iandchasse/de-link-pcb/simulations/led_driver/LED_circuit.asc

3v3_s: voltage; 3.3
C1: cap; 4.7µ
C2: cap; 4.7µ
C3: cap; 22µ
D1: schottky; MBR0540
D2: schottky; MBR0540
D8: LED; led_s; N=7
L1: ind; 10µ; Ipk=1.1 Rser=0.42 Rpar=7751.58 Cpar=0
M1: pmos; irlml6402
M2: pmos; irlml6402
Q1: npn
R1: res; 10k
R2: res; 10k
R3: res; 82
R4: res; 10k
R5: res; 10k
U1: LT1615
V1: voltage; 3.3
V2: voltage; 0
V3: voltage; PULSE(0 3.3v 0 1u 1u 5m 10m)
V4: voltage; PULSE(0 5v 0 1u 1u 5m 10m)
Named nets: 0, 3v3, LED_SW, LED_SENSE, LED_RET, LDO_IN
.SUBCKT irlml6402 1 2 3
**************************************
*      Model Generated by MODPEX     *
*Copyright(c) Symmetry Design Systems*
*         All Rights Reserved        *
*    UNPUBLISHED LICENSED SOFTWARE   *
*   Contains Proprietary Information *
*      Which is The Property of      *
*     SYMMETRY OR ITS LICENSORS      *
*Commercial Use or Resale Restricted *
*   by Symmetry License Agreement    *
**************************************
* Model generated on Sep 25, 06
* MODEL FORMAT: SPICE3
* Symmetry POWER MOS Model (Version 1.0)
* External Node Designations
* Node 1 -> Drain
* Node 2 -> Gate
* Node 3 -> Source
M1 9 7 8 8 MM L=100u W=100u
.MODEL MM PMOS LEVEL=1 IS=1e-32
+VTO=-1 LAMBDA=0.0111358 KP=12.788
+CGSO=5.36099e-06 CGDO=5.54234e-08
RS 8 3 0.0246704
D1 1 3 MD
.MODEL MD D IS=2.03395e-08 RS=0.0432758 N=1.5 BV=20
+IBV=0.00025 EG=1 XTI=4 TT=1e-07
+CJO=1.11974e-10 VJ=0.5 M=0.3 FC=0.5
RDS 3 1 5e+07
RD 9 1 0.0001
RG 2 7 29.2227
D2 5 4 MD1
* Default values used in MD1:
*   RS=0 EG=1.11 XTI=3.0 TT=0
*   BV=infinite IBV=1mA
.MODEL MD1 D IS=1e-32 N=50
+CJO=1.68841e-10 VJ=1.50027 M=0.3 FC=1e-08
D3 5 0 MD2
* Default values used in MD2:
*   EG=1.11 XTI=3.0 TT=0 CJO=0
*   BV=infinite IBV=1mA
.MODEL MD2 D IS=1e-10 N=0.4 RS=3e-06
RL 5 10 1
FI2 7 9 VFI2 -1
VFI2 4 0 0
EV16 10 0 9 7 1
CAP 11 10 9.68769e-10
FI1 7 9 VFI1 -1
VFI1 11 6 0
RCAP 6 10 1
D4 6 0 MD3
* Default values used in MD3:
*   EG=1.11 XTI=3.0 TT=0 CJO=0
*   RS=0 BV=infinite IBV=1mA
.MODEL MD3 D IS=1e-10 N=0.4
.ENDS irlml6402
.tran 50m startup
.model led_s D(Is=1p N=3.4 Rs=5)
