iandchasse/de-link-pcb/(commit log)

2026-03-22 current prototype
    [ESP32.kicad_sch, E_ink_HAT.kicad_sch, LED_control.kicad_sch, LiPo_In.kicad_sch, MicroSD_Out.kicad_sch, SH1106_OLED.kicad_sch, USBC_Power_UART.kicad_sch, buttons.kicad_sch]
2026-03-22 added logo, fixed dev header silk screen
    [minRead_pcb.kicad_pcb, minRead_pcb.kicad_sch]
